phiflip/RootDataLogger/Docs/Images/RootDataLogger_Inside_I.jpg

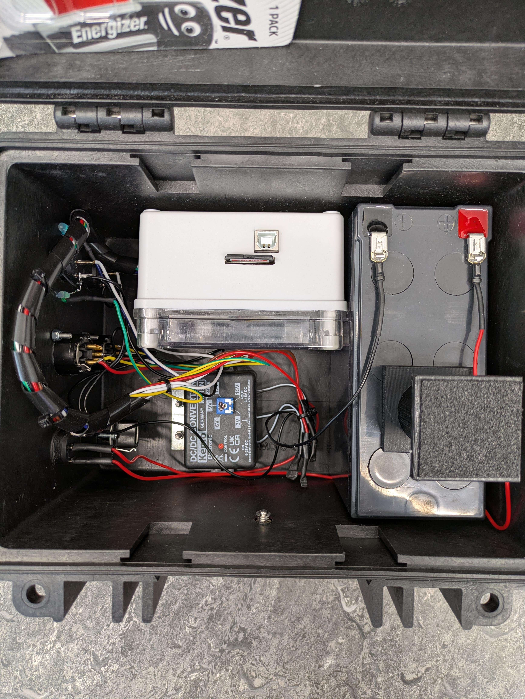
Docs/Images/RootDataLogger_Inside_I.jpg
