phiflip/RootDataLogger/Docs/Images/RootDataLogger_Inside_II.jpg

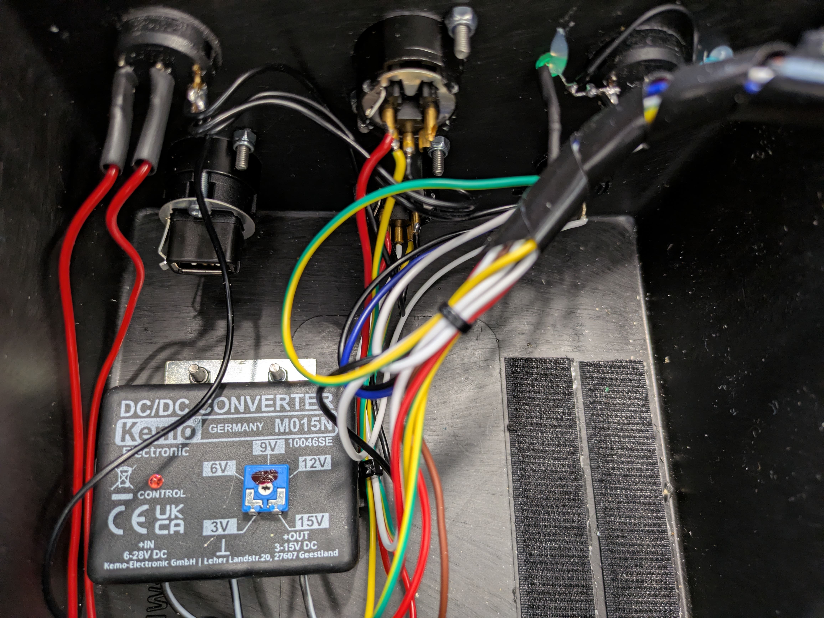
Docs/Images/RootDataLogger_Inside_II.jpg
