phiflip/RootDataLogger/Docs/Images/RootDataLogger_Inside_III.jpg

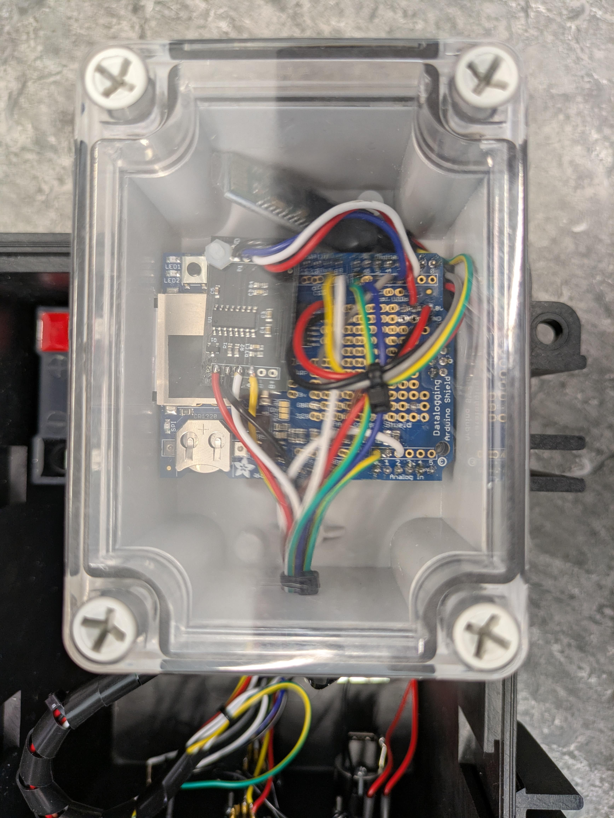
Docs/Images/RootDataLogger_Inside_III.jpg
