phiflip/RootDataLogger/Docs/Images/RootDataLogger_SensorPanel.jpg

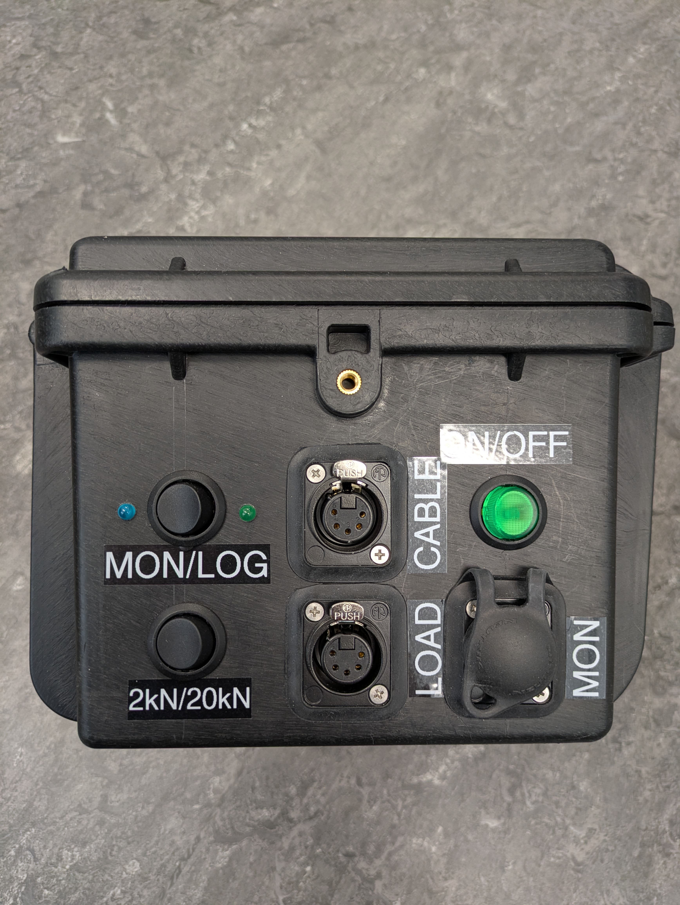
Docs/Images/RootDataLogger_SensorPanel.jpg
