phiflip/RootDataLogger/Docs/Images/RootDataLogger_Top.jpg

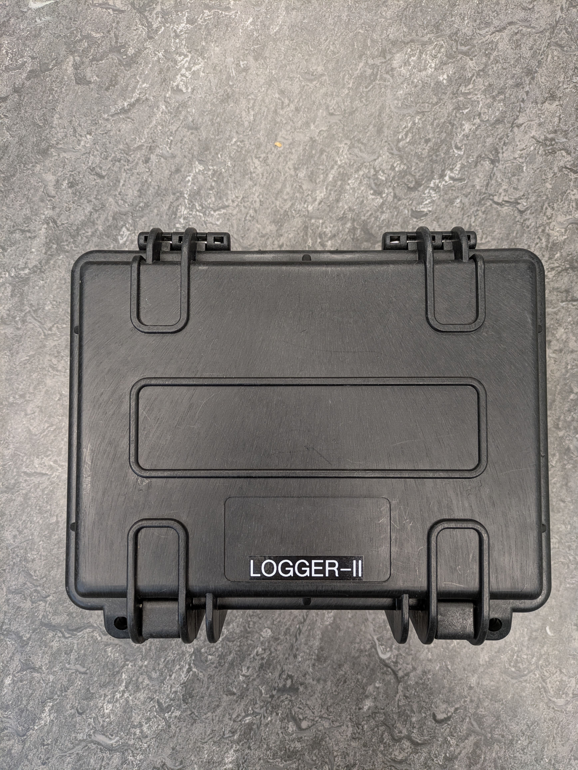
Docs/Images/RootDataLogger_Top.jpg
