phiflip/RootDataLogger/Scripts/Plots/RootDataLogger_I.png

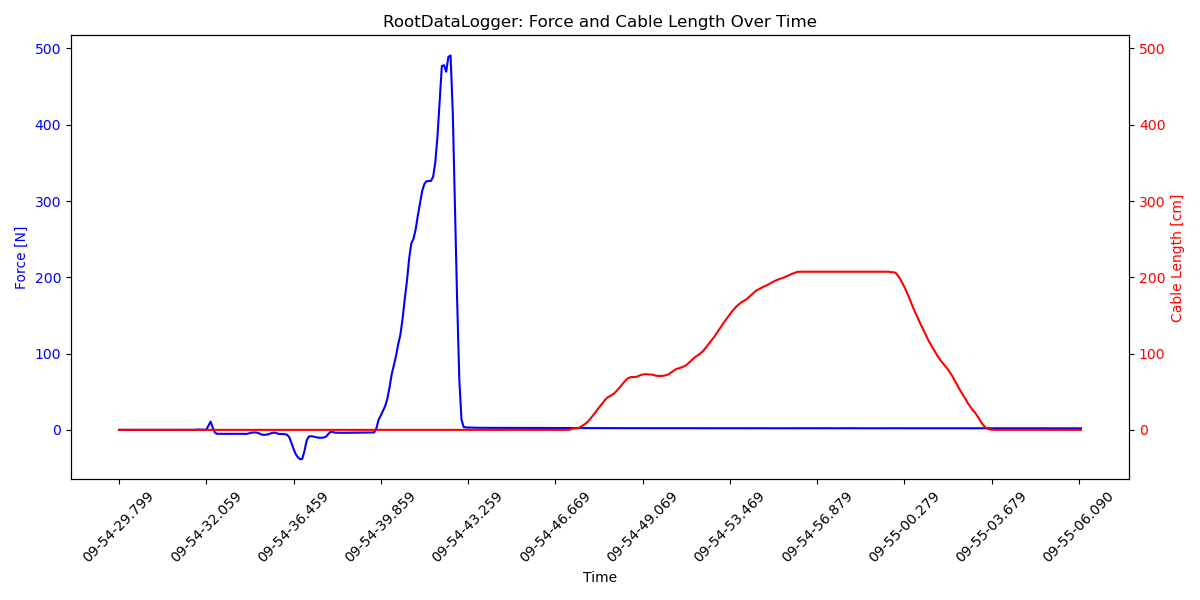
Scripts/Plots/RootDataLogger_I.png
