phiflip/RootDataLogger/Scripts/Plots/RootDataLogger_II.png

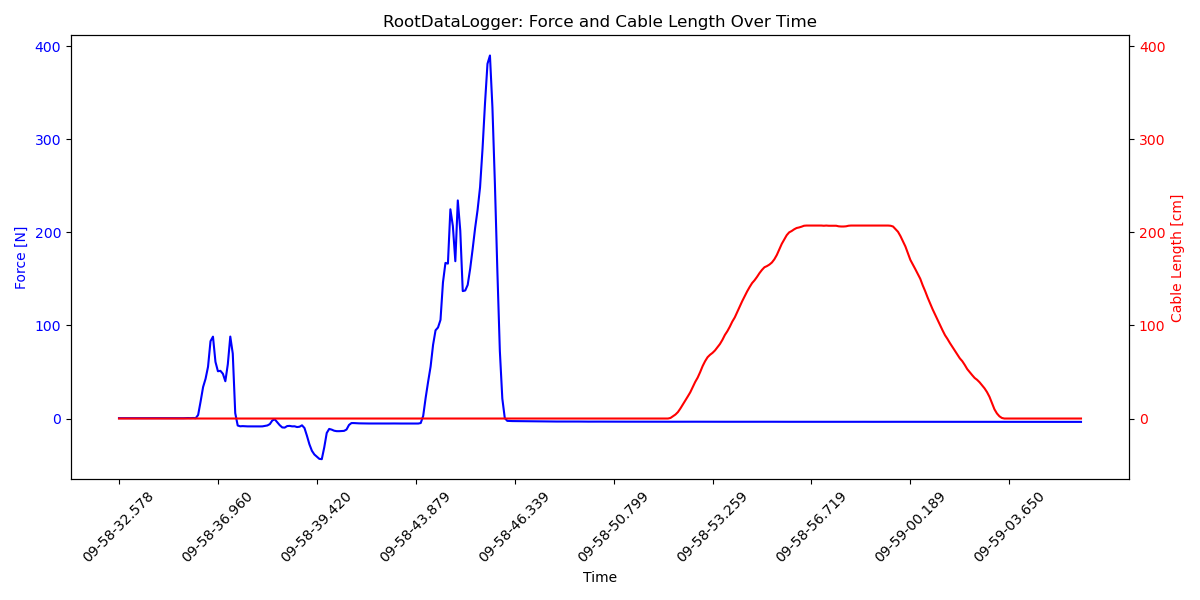
Scripts/Plots/RootDataLogger_II.png
