phiflip/RootDataLogger/Docs/Schematics/SchematicDiagram_RootDataLogger.pdf

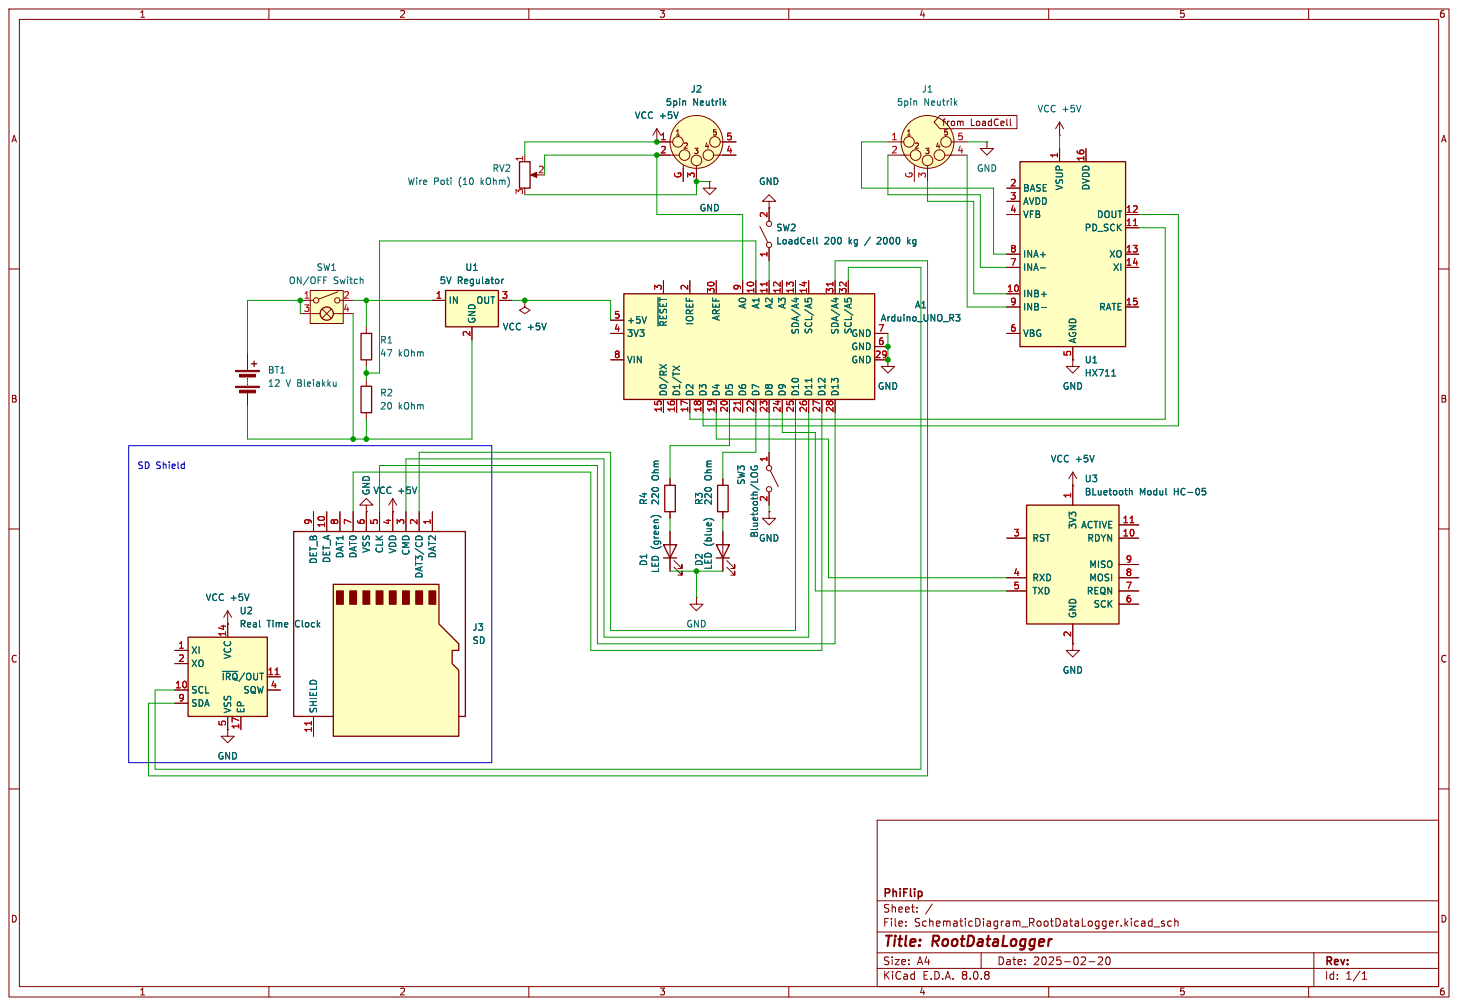
[picture p9: page 1]

3 RV2 Wire Poti (10 kOhm) VSUP

5 SDA 9 U2 Real Time Clock GND

1 2 A1 Arduino_UNO_R3 A1 10 A2 11 A3 12 SDA/A4 13 SCL/A5 14 D0/RX 15 D1/TX 16 D2 17 D3 18 D4 19 IOREF

9 R4 220 Ohm R3 220 Ohm D1 LED (green) U3BLuetooth Modul HC-05 3V3

2 D5 20 D6 21 D7 22 D8 23 D9 24 D10 25 D11 26 D12 27 D13 28 GND 29 ~{RESET}3 AREF 30 SDA/A4 31 SCL/A5 32

1 2 SW3 Bluetooth/LOG D2 LED (blue)

VCC +5V GND SW3 Bluetooth/LOG

2 RST 3 RXD 4 TXD 5 SCK 6 REQN 7 MOSI 8 MISO 9 U3BLuetooth Modul HC-05 GND

2 RST 3 RXD 4 TXD 5 SCK 6 REQN 7 MOSI 8 MISO 9 GND

Id: 1/1 Title: RootDataLogger File: SchematicDiagram_RootDataLogger.kicad_sch Sheet: / PhiFlip
